twann503/Electric-Scooter-Brushless-Motor-Controller/Weekly Reports/Justin/Justin-11-14.docx

What I did:

We printed a new copper board with our improved components.

Obstacles:

90% of the time spent fixing problems in the lab with these fine gentlemen have been because of this GODAMN COPPER BOARD, its so utterly terrible with copper shoring everything and peeling off easily when we try to fix the solder.

What I plan:

I will start drawing some rudimentary mechanical design for our scooter.
