twann503/Electric-Scooter-Brushless-Motor-Controller/Weekly Reports/Justin/Justin-11-21.docx

What I did:

Joining my team mebers in the lab, trying to debug our bldc controller. We have got the motor running at this stage, but like forrest mentioned the gate driver isn’t functioning as well as intended.

Obstacles:

Weve had so many problems with these copper boards. They are truly the worst for prototyping. Rather just suck it up and pay the big bucks for real solder mask.

What’s next week:

Once we get the osh park boards, that will have our new microprocessor on it. Maybe I can help start the programming on that.
