twann503/Electric-Scooter-Brushless-Motor-Controller/Weekly Reports/Justin/Justin-11-28.docx

What I did:

I helped thuan research on how this Atmel studio suite works, and how we can connect our processor. I also spent lot of time over the long weekend finishing up the drawings for our mechanical design. The scooter will need to be manufactured to support our weight and function as a normal scooter.

Obstacles:

Apparently while I was away the 22.2V battery blew up the board. Just when things were going so great.

What I plan to do:

Need to find a place to get aluminum and start machining these pieces. We need this thing built fast.
