twann503/Electric-Scooter-Brushless-Motor-Controller/Weekly Reports/Justin/Justin-11-7.docx

What I did:

Talked with Forrest about the circuit design, it seemed he has most of it done now

Obstacles:

Time, need to wait until this is printed, then we can start mapping our stages.

What I plan to do:

Familiarize myself with the inner workings of BLDC motor control, and how hall effect sensors work.
