twann503/Electric-Scooter-Brushless-Motor-Controller/Weekly Reports/Forrest/Forrest 11-22.docx

What I did this week:

We’ve been working with our board from the LID and so far the gate driver appears to be struggling. The 2n7000’s that we’ve been using appear to work correctly, but we’ve had to replace several. Other than the the motor appears to be correctly following our state transition graph correctly.

Obstacles?:

This board is taking awhile to get working due to not having soldermask.

What I plan to do next week:

We will be getting the OSHpark board soon, so I’m preparing to receive those and boot one of our processors and transfer our code to a processor.
