twann503/Electric-Scooter-Brushless-Motor-Controller/Weekly Reports/Forrest/Forrest 11-8.docx

What I did this week:

This week I am still working on getting a preliminary board design up so we can print something from the LID

Obstacles?:

Right now time is my only obstacle and I am also trying to reduce my number of on board vias so we don’t have to do them manually.

What I plan to do next week:

Next week we plan to print, assemble and test our first motor driver using the IRFS mosfets.
