twann503/Electric-Scooter-Brushless-Motor-Controller/Weekly Reports/Forrest/Forrest 12-6.docx

What I did this week:

Our group presented, we’re done! The scooter appears to work, though we didn’t demo it with the 22.2V battery for the demo due to fear it would explode like the last two boards.

Obstacles?:

Just a general lack of time.

What I plan to do next week:

Sleep off the estimated 300 hours I’ve put in this thing.
