twann503/Electric-Scooter-Brushless-Motor-Controller/Weekly Reports/Thuan/Thuan Pham Week3.pdf

Thuan Pham
ECE 411
Week3

Weekly Log

Started to gather parts for circuit board and project design. Forrest was building the circuit. I didn’t do too much that week. But everything was on track.
