twann503/Electric-Scooter-Brushless-Motor-Controller/Weekly Reports/Thuan/Thuan Pham Week4.pdf

Thuan Pham
ECE 411
Week4

Weekly Log

Looked into BLDC motor design and how they worked. Worked with team on Ardiuno prototyping so that we can drive the motor. Talked about circuit design with Forrest. Forrest explained how his design was going to work. Didn’t do much else rest of week
