twann503/Electric-Scooter-Brushless-Motor-Controller/Weekly Reports/Thuan/Thuan Pham Week5.pdf

Thuan Pham
ECE 411
Week5

Weekly Log

Spent week to look into design scooter with gear and having discussions with teammates about design of the mount of scooter with motor and the circuit. Spent time with programing our motor to make sure we find the correct positon of the motor and that it is movable. We used ardiuno to prototype our program.
