twann503/Electric-Scooter-Brushless-Motor-Controller/Weekly Reports/Thuan/Thuan Pham Week7.pdf

Thuan Pham
ECE 411
Week7

Weekly Log

Spent whole week trying to test the circuit board. Got so many problems. Board got really hot and smoked. Mosfets burnt out. We replaced it to see if that would fix it. It didn’t spent rest of week trying to fix it. No luck. In the end called the board dead and decided to rout out a new copper board.
