twann503/Electric-Scooter-Brushless-Motor-Controller/Weekly Reports/Thuan/Thuan Pham Week8.pdf

Thuan Pham
ECE 411
Week8

Weekly Log

Routed out the new board. Soldered it up. When testing connections, the board had shorts. Could not figure out why. Spent whole day debugging and finally figured out solution to fix the short. Cut all the leftover traces. Got the board to work finally. Connected it up and got it running. Later another part burnt out. Tried replacing again. Spent more time debugging. Got it to finally work.
