twann503/Electric-Scooter-Brushless-Motor-Controller/Weekly Reports/Thuan/Thuan Pham Week9.pdf

Thuan Pham
ECE 411
Week9

Weekly Log

With the copper board working, we learned our lesson to never use copper boards because they create too many problems with shorting; however, with our board finally working we were able to start programing the board correctly. Spent rest of week programing the board to make sure it can drive the motor along with the pot to control speed. Other teammate work on creating the final design to submit the PCB to OshPark. Spent all thanksgiving weeked learning to program on our atmega 328p.
