twann503/Electric-Scooter-Brushless-Motor-Controller/Weekly Reports/Thuan/Thuan Pham Week6.pdf

Thuan Pham
ECE 411
Week6

Weekly Log

This week, I went ahead and got all the components for the PCB. I spent some time to solder on all the MOSFETS. We almost soldered on some surface mount resistors and I tested the PCB for all its connections to make sure nothing shorted and all the components had the proper connections. We later met that week and planned a testing phase to test the PCB with all the components. We got the motor to move, but it didn’t move very smoothly, need to do more modifications and figure out what is causing it to not spin smoothly
