twann503/Electric-Scooter-Brushless-Motor-Controller/Weekly Reports/Thuan/Thuan Pham Week1.docx

Thuan Pham

ECE 411

Week1

Weekly Log

Created our team and that’s all.
