twann503/Electric-Scooter-Brushless-Motor-Controller/EAGLECAD Designs/BLDC Motor Rev 2/BLDC Motor.brd

## EAGLE design EAGLECAD Designs/BLDC Motor Rev 2/BLDC Motor.brd (2016-11-17)

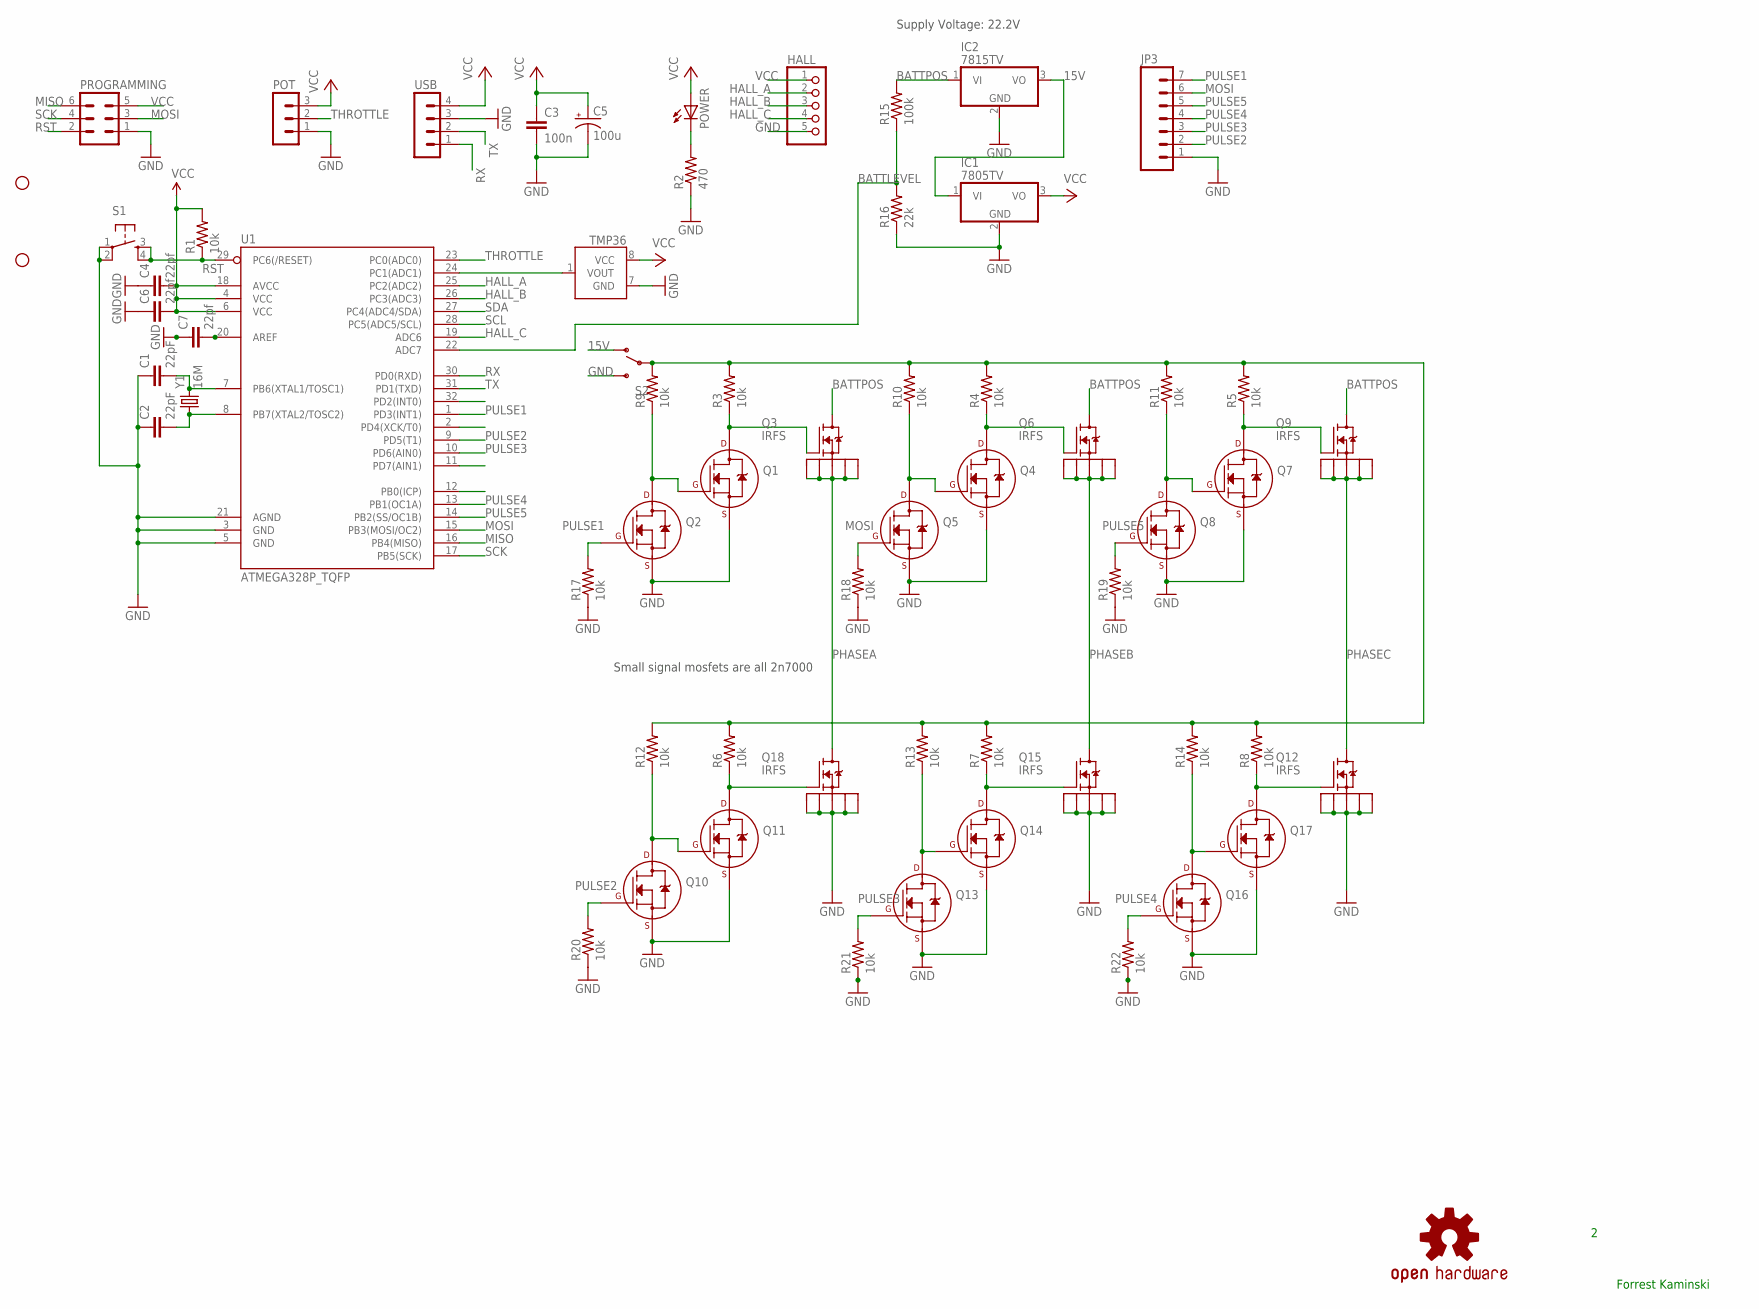
[picture p18: schematic BLDC Motor.sch]

Parts:
C1, C2: 22pF; 0805
C3: 100n; 0805
C4, C6, C7: 22pf; 0805
C5: 100u; CPOL-RADIAL-100UF-25V
HALL: PINHD-1X5; 1X05
IC1: 7805TV; TO220V
IC2: 7815TV; TO220V
JP1, JP2: STAND-OFF
JP3: M07; 1X07
POT: MA03-1
POWER: LEDSML0805; SML0805
PROGRAMMING: MA03-2
Q1, Q2, Q4, Q5, Q7, Q8, Q10, Q11, Q13, Q14, Q16, Q17: 2N7000_TO92; TO-92
Q3, Q6, Q9, Q12, Q15, Q18: IRFS; D2PAK-7
R1, R3, R4, R5, R6, R7, R8, R9, R10, R11, R12, R13, R14, R17, R18, R19, R20, R21, R22: 10k; 0805
R2: 470; 0805
R15: 100k; 0805
R16: 22k; 0805
S1: TAC_SWITCHPTH; TACTILE-PTH
S2: SWITCH-SPSTPTH_LOCK; SWITCH-SPDT_LOCK.007S
TMP36: TMP36SOIC; SOIC8
U1: ATMEGA328P_TQFP; TQFP32-08
U$1: OSHW-LOGOS; OSHW-LOGO-S
USB: MA04-1
Y1: 16M; HC49US

Connections:
15V: IC1.1 (VI), IC2.3 (VO), S2.1 (O)
BATTLEVEL: R15.1, R16.2, U1.22 (ADC7)
BATTPOS: IC2.1 (VI), Q3.D, Q6.D, Q9.D, R15.2
GND: C1.1, C2.1, C3.2, C4.1, C5.2 (-), C6.1, C7.1, HALL.5, IC1.2 (GND), IC2.2 (GND), JP3.1, POT.1, PROGRAMMING.1, Q1.1 (S), Q2.1 (S), Q4.1 (S), Q5.1 (S), Q7.1 (S), Q8.1 (S), Q10.1 (S), Q11.1 (S), Q12.S1, Q12.S2, Q12.S3, Q12.S4, Q12.S5, Q13.1 (S), Q14.1 (S), Q15.S1, Q15.S2, Q15.S3, Q15.S4, Q15.S5, Q16.1 (S), Q17.1 (S), Q18.S1, Q18.S2, Q18.S3, Q18.S4, Q18.S5, R2.1, R16.1, R17.1, R18.1, R19.1, R20.1, R21.1, R22.1, S1.1, S1.2, S2.3 (S), TMP36.7 (GND), U1.3 (GND), U1.5 (GND), U1.21 (AGND), USB.3
HALL_A: HALL.2, U1.25 (PC2(ADC2))
HALL_B: HALL.3, U1.26 (PC3(ADC3))
HALL_C: HALL.4, U1.19 (ADC6)
MISO: PROGRAMMING.6, U1.16 (PB4(MISO))
MOSI: JP3.6, PROGRAMMING.3, Q5.2 (G), R18.2, U1.15 (PB3(MOSI/OC2))
unnamed: C2.2, U1.8 (PB7(XTAL2/TOSC2)), Y1.1
unnamed: C1.2, U1.7 (PB6(XTAL1/TOSC1)), Y1.2
unnamed: POWER.C, R2.2
unnamed: Q10.3 (D), Q11.2 (G), R12.1
unnamed: Q1.3 (D), Q3.G, R3.1
unnamed: TMP36.1 (VOUT), U1.24 (PC1(ADC1))
unnamed: C7.2, U1.20 (AREF)
unnamed: Q1.2 (G), Q2.3 (D), R9.1
unnamed: Q4.3 (D), Q6.G, R4.1
unnamed: Q4.2 (G), Q5.3 (D), R10.1
unnamed: R3.2, R4.2, R5.2, R6.2, R7.2, R8.2, R9.2, R10.2, R11.2, R12.2, R13.2, R14.2, S2.2
unnamed: Q7.3 (D), Q9.G, R5.1
unnamed: Q7.2 (G), Q8.3 (D), R11.1
unnamed: Q11.3 (D), Q18.G, R6.1
unnamed: Q13.3 (D), Q14.2 (G), R13.1
unnamed: Q12.G, Q17.3 (D), R8.1
unnamed: Q16.3 (D), Q17.2 (G), R14.1
unnamed: Q14.3 (D), Q15.G, R7.1
PHASEA: Q3.S1, Q3.S2, Q3.S3, Q3.S4, Q3.S5, Q18.D
PHASEB: Q6.S1, Q6.S2, Q6.S3, Q6.S4, Q6.S5, Q15.D
PHASEC: Q9.S1, Q9.S2, Q9.S3, Q9.S4, Q9.S5, Q12.D
PULSE1: JP3.7, Q2.2 (G), R17.2, U1.1 (PD3(INT1))
PULSE2: JP3.2, Q10.2 (G), R20.2, U1.9 (PD5(T1))
PULSE3: JP3.3, Q13.2 (G), R21.2, U1.10 (PD6(AIN0))
PULSE4: JP3.4, Q16.2 (G), R22.2, U1.13 (PB1(OC1A))
PULSE5: JP3.5, Q8.2 (G), R19.2, U1.14 (PB2(SS/OC1B))
RST: PROGRAMMING.2, R1.1, S1.3, S1.4, U1.29 (PC6(/RESET))
RX: U1.30 (PD0(RXD)), USB.1
SCK: PROGRAMMING.4, U1.17 (PB5(SCK))
SCL: U1.28 (PC5(ADC5/SCL))
SDA: U1.27 (PC4(ADC4/SDA))
THROTTLE: POT.2, U1.23 (PC0(ADC0))
TX: U1.31 (PD1(TXD)), USB.2
VCC: C3.1, C4.2, C5.1 (+), C6.2, HALL.1, IC1.3 (VO), POT.3, POWER.A, PROGRAMMING.5, R1.2, TMP36.8 (VCC), U1.4 (VCC), U1.6 (VCC), U1.18 (AVCC), USB.4

Notes on the sheet:
Supply Voltage: 22.2V
Forrest Kaminski
Small signal mosfets are all 2n7000

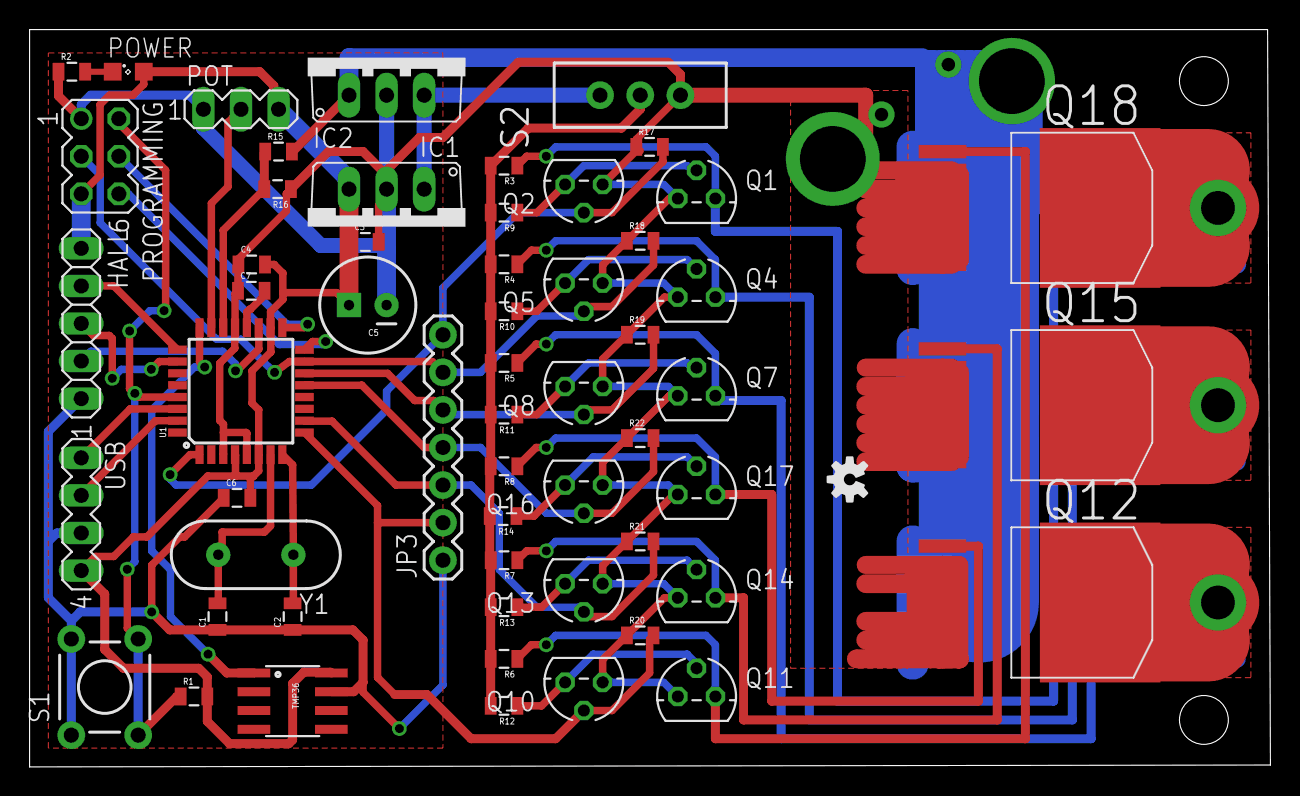
[picture p19: board BLDC Motor.brd from above]

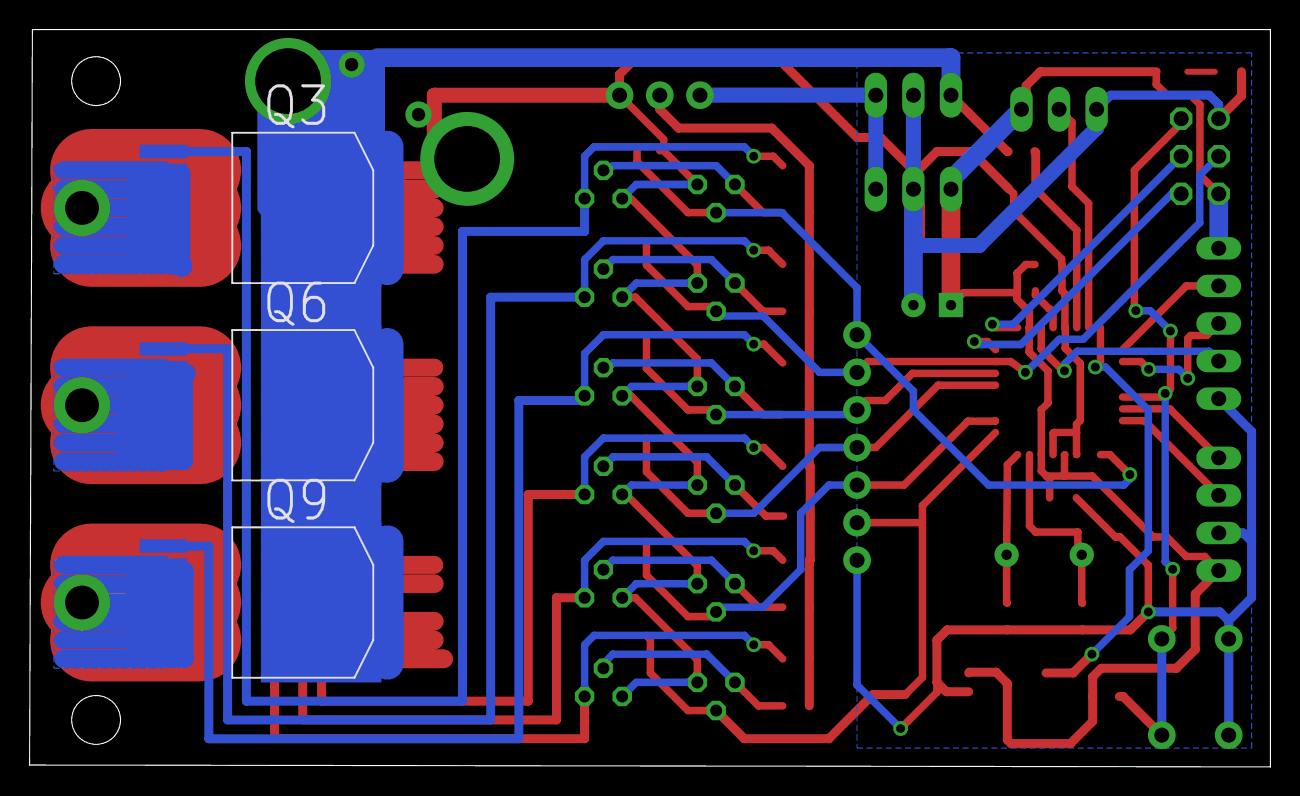
[picture p20: board BLDC Motor.brd from below]

Board: 2 copper layers, 83.9 x 49.8 mm, 63 parts (3 on the bottom side), 41 nets.
