twann503/Electric-Scooter-Brushless-Motor-Controller/(commit log)

2016-10-11 Added Eagle Files
    [BLDC Motor Driver.brd, BLDC Motor Driver.sch]
2016-10-28 Adding rev .2 to board files
    [BLDC Motor.brd, BLDC Motor.sch]
2016-11-01 Changing the Rev 2 board up
    [BLDC Motor.brd, BLDC Motor.sch]
2016-11-01 removed old rev 2 folder
    [BLDC Motor.brd, BLDC Motor.sch]
2016-11-03 Updated BLDC schematic
    [BLDC Motor.brd, BLDC Motor.sch]
2016-11-08 Updating board
    [BLDC Motor Driver.brd, BLDC Motor Driver.sch, BLDC Motor.brd, BLDC Motor.sch]
2016-11-08 added gantt chart
    [BLDC_Scooter_Schedule_Gantt2.xlsx]
2016-11-10 Adding capacitors to the processor for better stability
    [BLDC Motor.brd, BLDC Motor.sch]
2016-11-15 Updated Gate driver on board, moved weekly reports to folder
    [BLDC Motor.brd, BLDC Motor.sch]
2016-11-17 Final board design, added test arduino code
    [BLDC Motor.brd, BLDC Motor.sch]
2016-11-23 Changing arduino code
2016-12-06 Reorganized our directory
    [BLDC - Gnatt.xlsx, BLDC Motor.brd, BLDC Motor.sch, BLDC_Scooter_Schedule_Gantt2.xlsx]
2016-12-06 64k PWM
2016-12-06 Final working code
    Added 300Hz PWM ontop of 64KHz PWM wave to control speed
